ami3go/StepLoad-Arduino-UNO/Pictures/DSC_2040.JPG

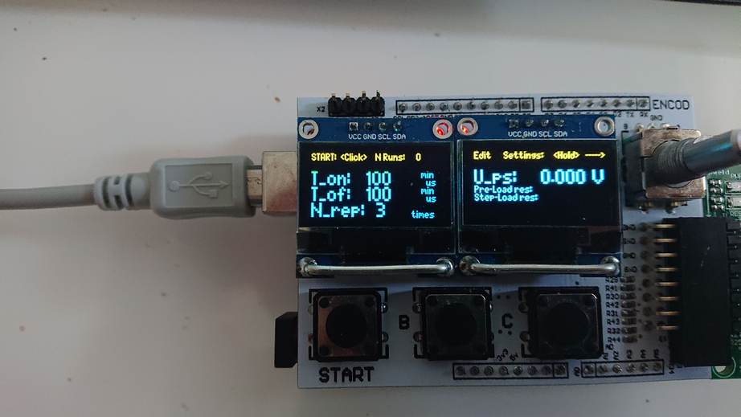
Pictures/DSC_2040.JPG
