ami3go/StepLoad-Arduino-UNO/Pictures/DSC_2055.JPG

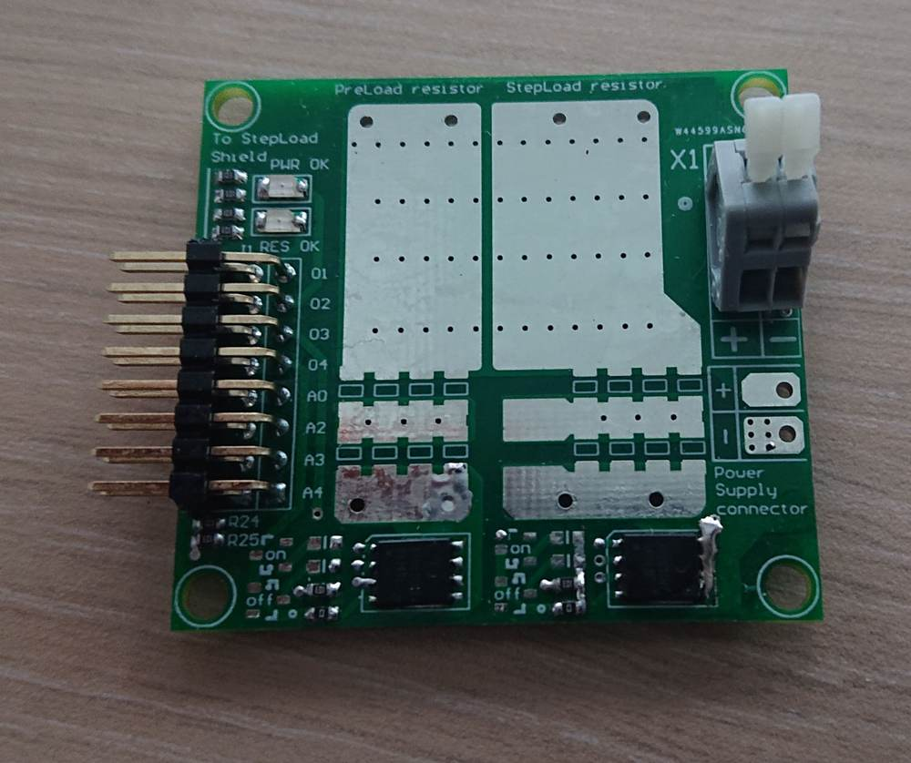
Pictures/DSC_2055.JPG
