ami3go/StepLoad-Arduino-UNO/Pictures/DSC_2058.JPG

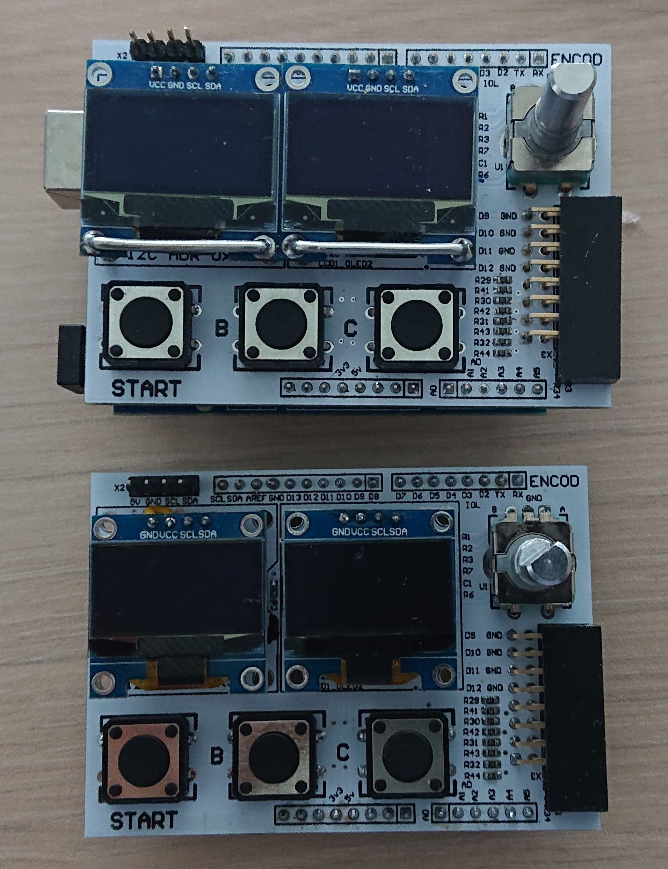
Pictures/DSC_2058.JPG
