ami3go/StepLoad-Arduino-UNO/Hardware/Shield_board/BOM/Bill of Materials-Arduino_Generator.xls

Designator | Description | Footprint | Quantity | Order Code
AD | 6 pins 2.54 header male | Header 6x1 8.5mm | 1
C1, C4_A, C4_B, C4_C, C5, C6, C7, C8 | 100nF 25V 0603 | 0603c | 8 | CC0603KRX7R8BB104
C2, C3 | 10nF 25V 5% 0603 NPO | 0603c | 2 | GRM1885C1E103JA01J
IOH | 10 pins 2.54 header male | Header 10x1 8.5mm | 1
IOL | 8 pins 2.54 header male | Header 8x1 8.5mm | 1
LCD1_OLED1, LCD1_OLED2 | SSD1306 OLED | 128x64I2COLEDDisplayAdafruit | 2 | link to Aliexpress (https://www.aliexpress.com/item/32277460222.html)
POWER | 8 pins 2.54 header male | Header 8x1 8.5mm | 1
R1, R2, R3, R10_A, R10_B, R10_C, R23, R24 | 10k 0603 5% | 0603r | 8 | RC0603JR-0710KL
R4, R5, R6, R7, R8, R9, R11_A, R11_B, R11_C, R12_A, R12_B, R12_C, R16, R20, R21, R22, R25, R26, R27, R28 | 100R 0603 1% | 0603r | 20 | RC0603FR-07100RL
R29, R30, R31, R32 | 10k 0603 1% | 0603r | 4 | RC0603FR-0710K
R33, R34, R37, R38 | 0R 0603 5% | 0603r | 4 | RC0603JR-070R
R41, R42, R43, R44 | 3.3KOhms 1% 1/10W 0603 RoHS | 0603r | 4 | RC0603FR-073K3L
SW1_A, SW1_B, SW1_C | Tactile switch 12x12mm Std Ht 7.3 Gen Purpose 130g | SWICH5B | 3 | 95C12C3T
U1 | Undefined or Miscellaneous | ACZ11BR1E15FD112C | 1 | ACZ11BR1E-15FD1-12C
U2 | 256 Kb I2C 2 Wire (32K X 8) 2.5 V Serial EEPROM SMT - SOIC-8 | SO8_P1.27_W3.9_L4.90 | 1 | 24LC256-I/SN
U3, U4 | 3A Dual High-Speed Power MOSFET Drivers, Non Inverting, Extended Temperature, Tape and Reel | SOIC-OA8_L | 2 | TC4424AVOA713, [NoParam]
VD1, VD2 | 40V 250mA 0.57V 5ns 6pF | SOT-23-3 | 2 | BAT64E6327
X2 | 4pin 2.54 vertical | M20-9990445 | 1 | M20-9990445
X3 | SQ Post Socket, Through-hole, Right Angle, -55 to 125 degC, 2.54mm Pitch, 16-Pin, Female, RoHS | SMTC-SSW-108-02-X-D-RA | 1 | SMTC-SSW-108-02-X-D-RA
