ami3go/StepLoad-Arduino-UNO/Hardware/Switch_board_small/SwitchBoard_small.PDF

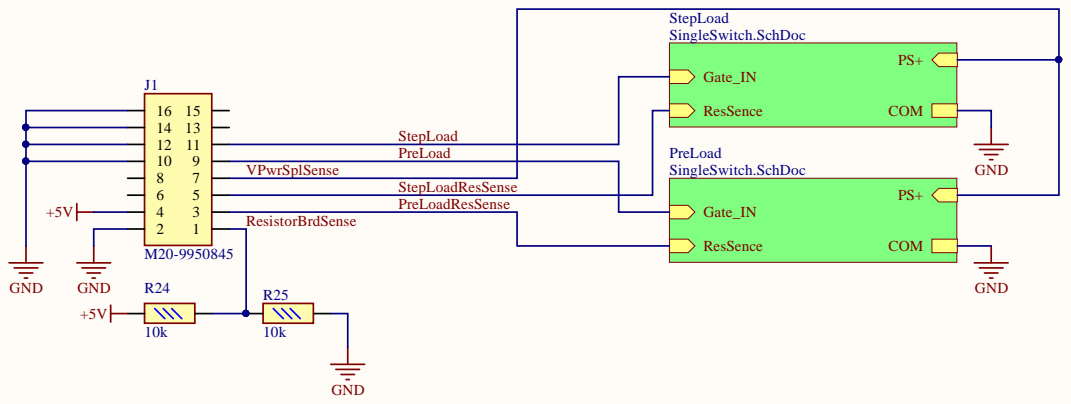
[picture p36: page 1]

StepLoad
PreLoad

VPwrSplSense

StepLoadResSense | PS+ Gate_IN
PreLoadResSense

ResistorBrdSense

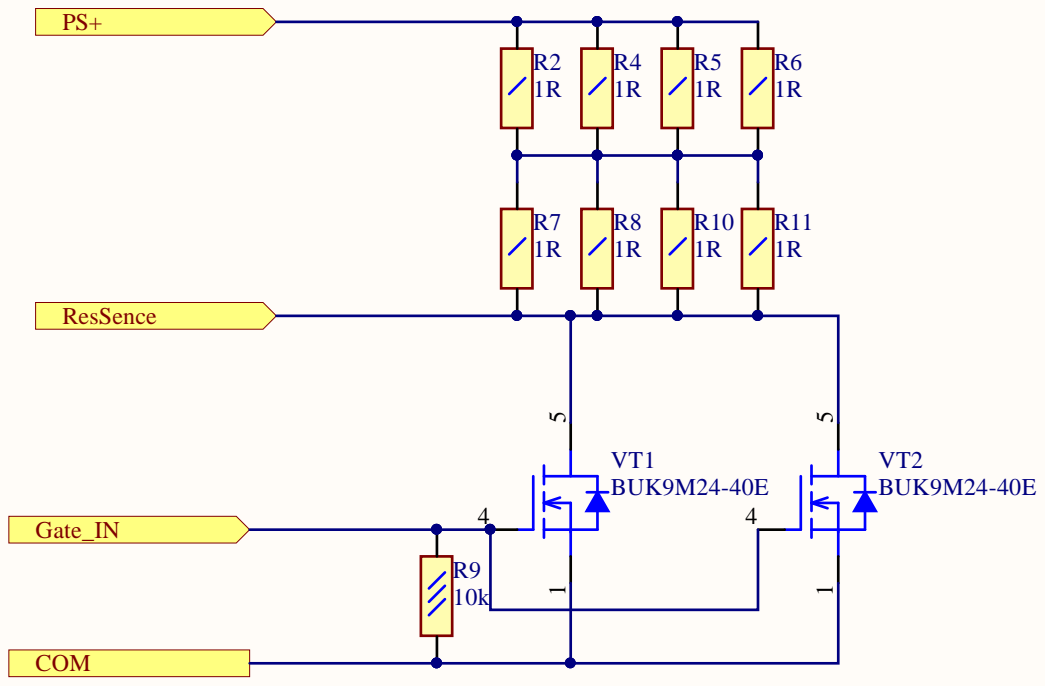
[picture p37: page 2]

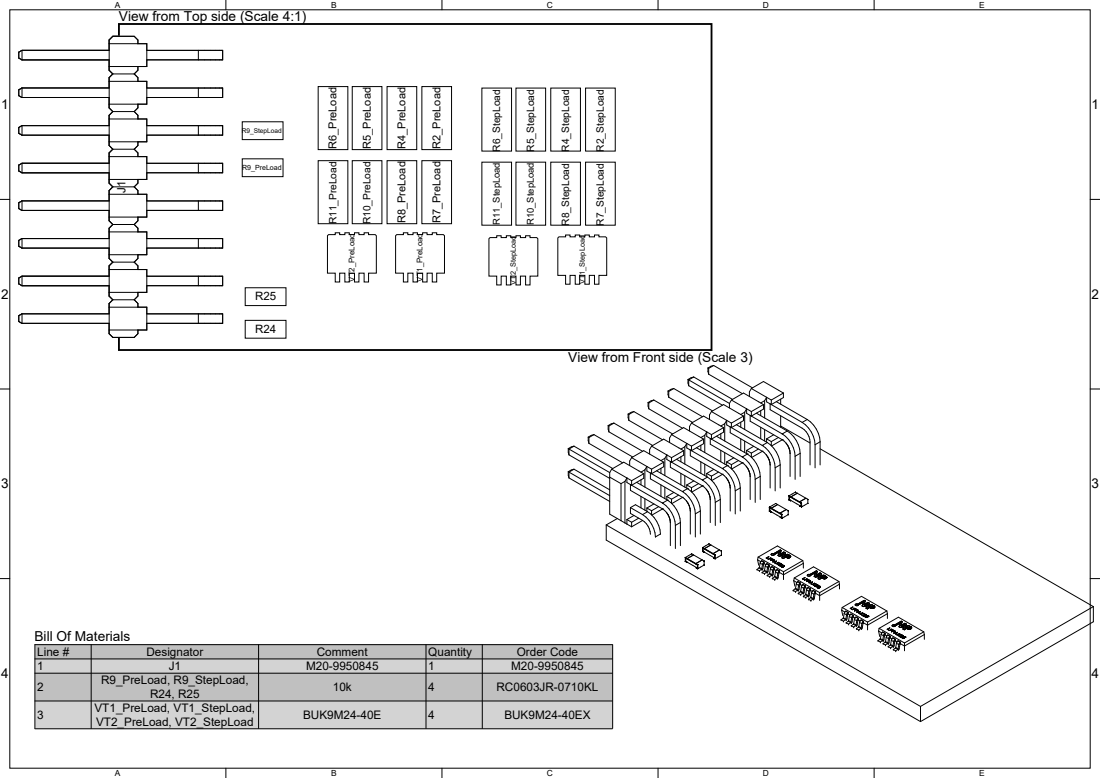
[picture p38: page 3]

View from Top side (Scale 4:1)

View from Front side (Scale 3)
