ami3go/StepLoad-Arduino-UNO/Hardware/Shield_board/Schematic/Arduino_Generator.PDF

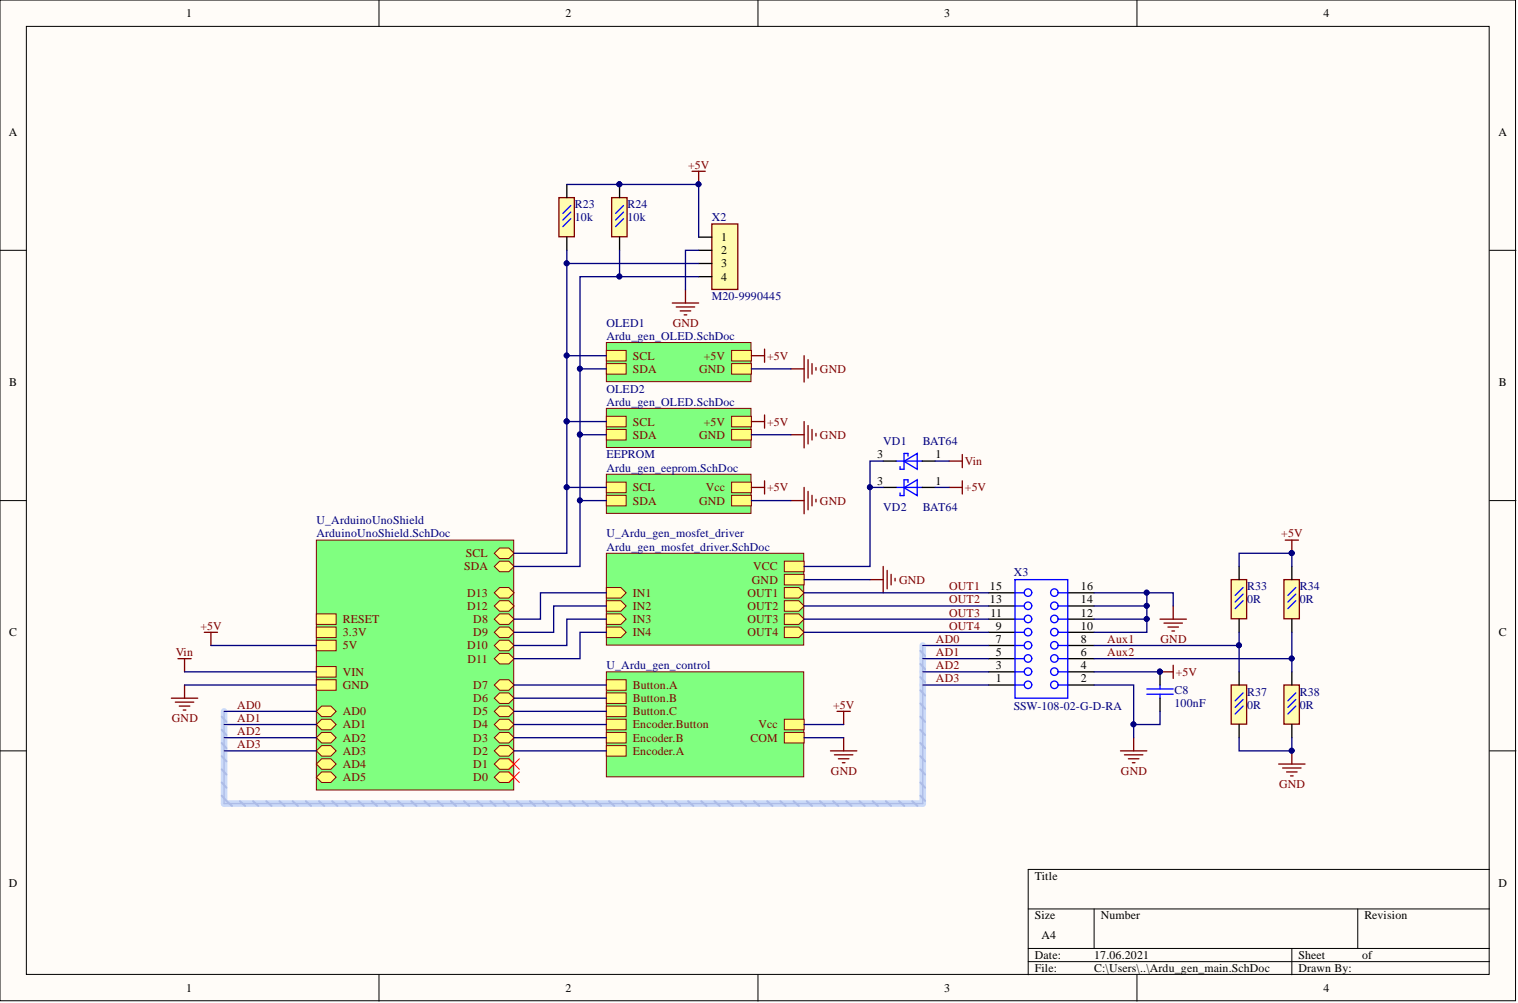
[picture p39: page 1]

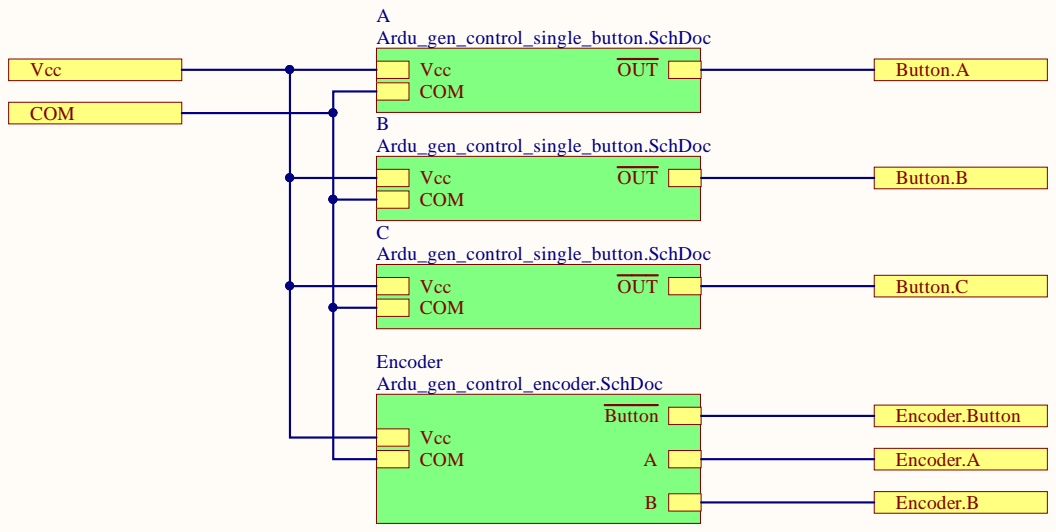
[picture p40: page 2]

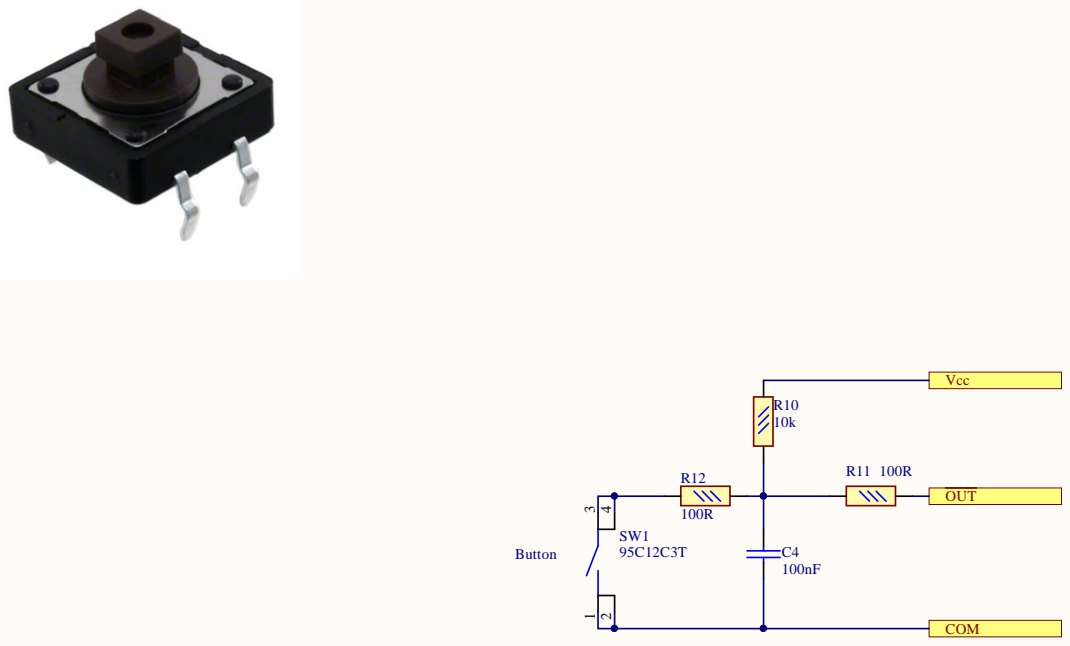
[picture p41: page 3]

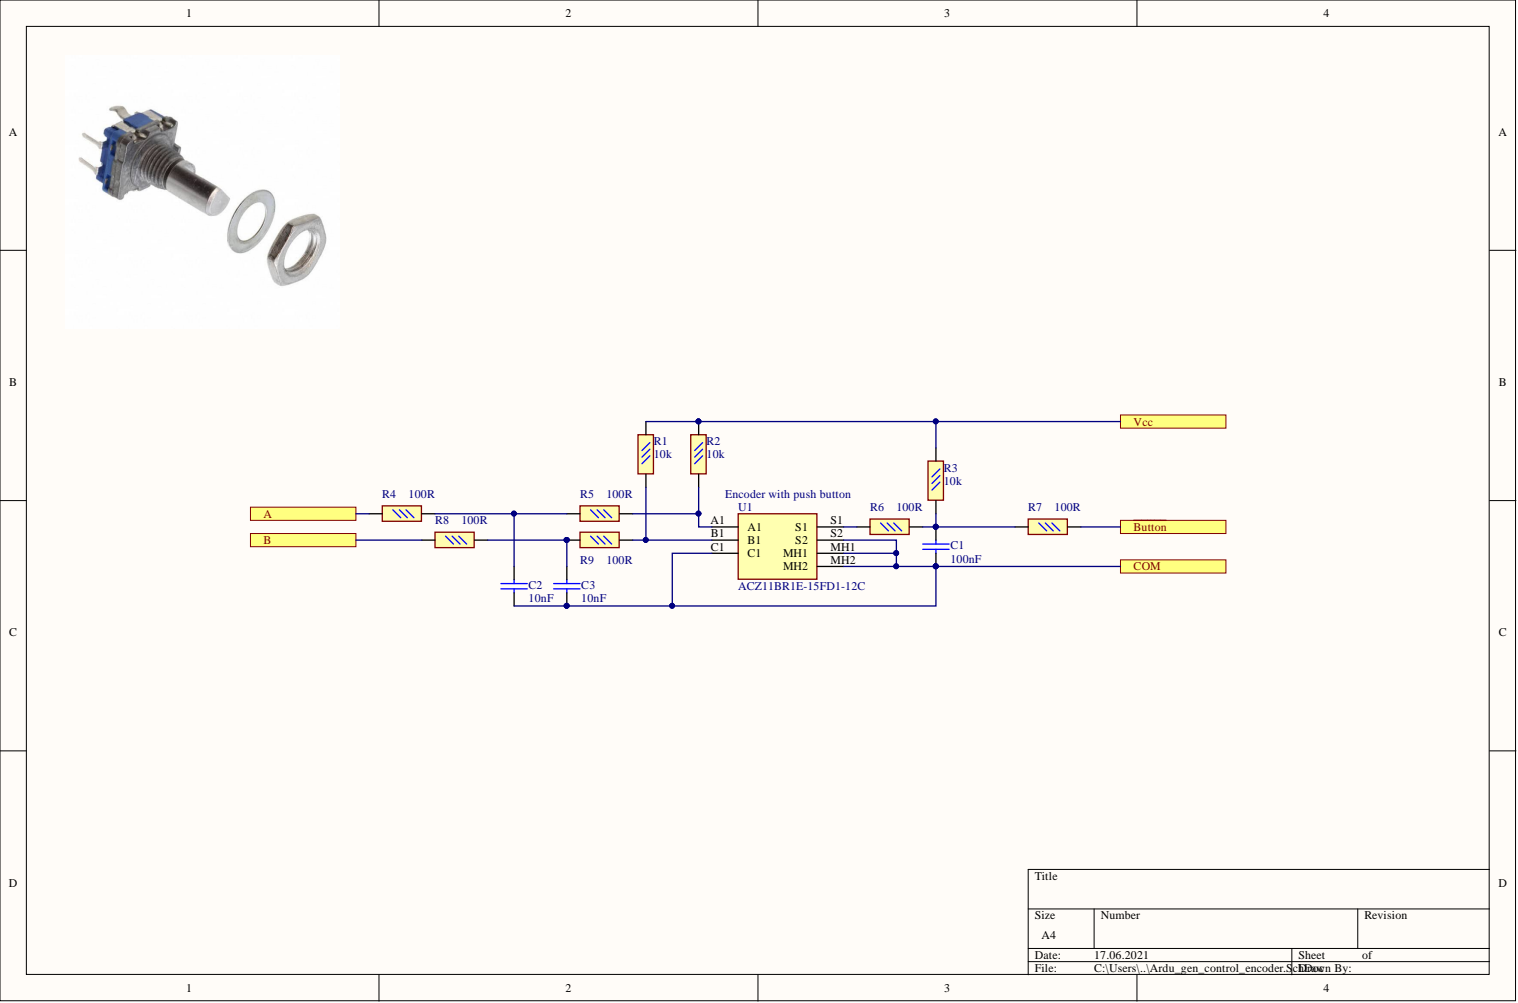
[picture p42: page 4]

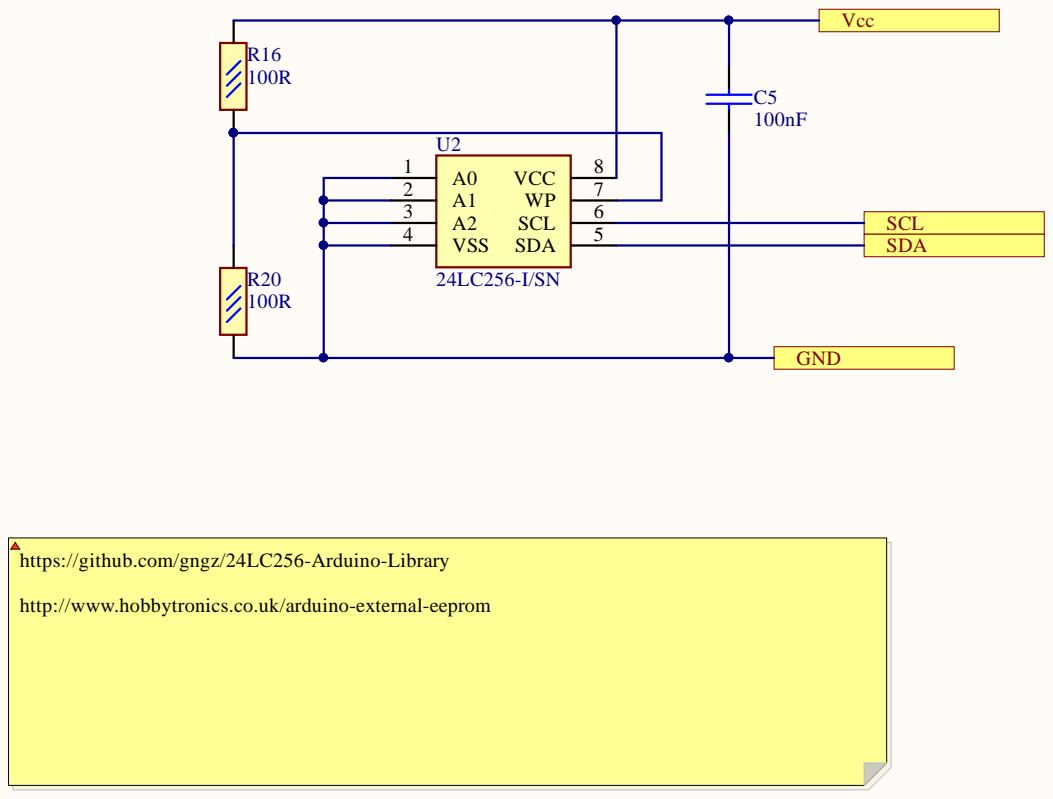
[picture p43: page 5]

https://github.com/gngz/24LC256-Arduino-Library

http://www.hobbytronics.co.uk/arduino-external-eeprom

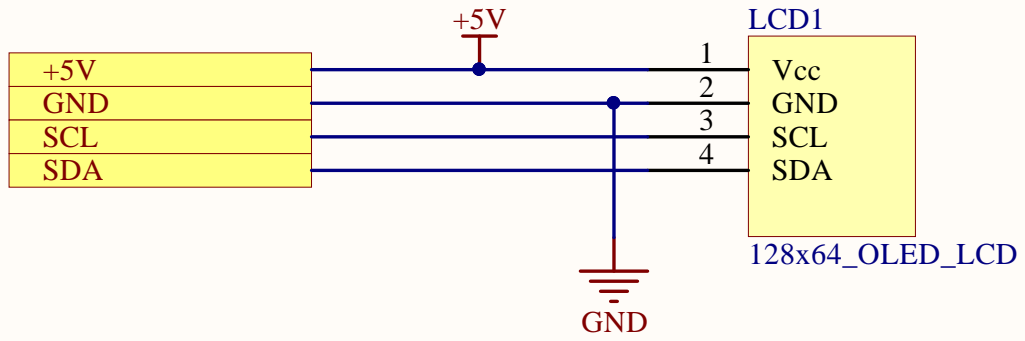
[picture p44: page 6]

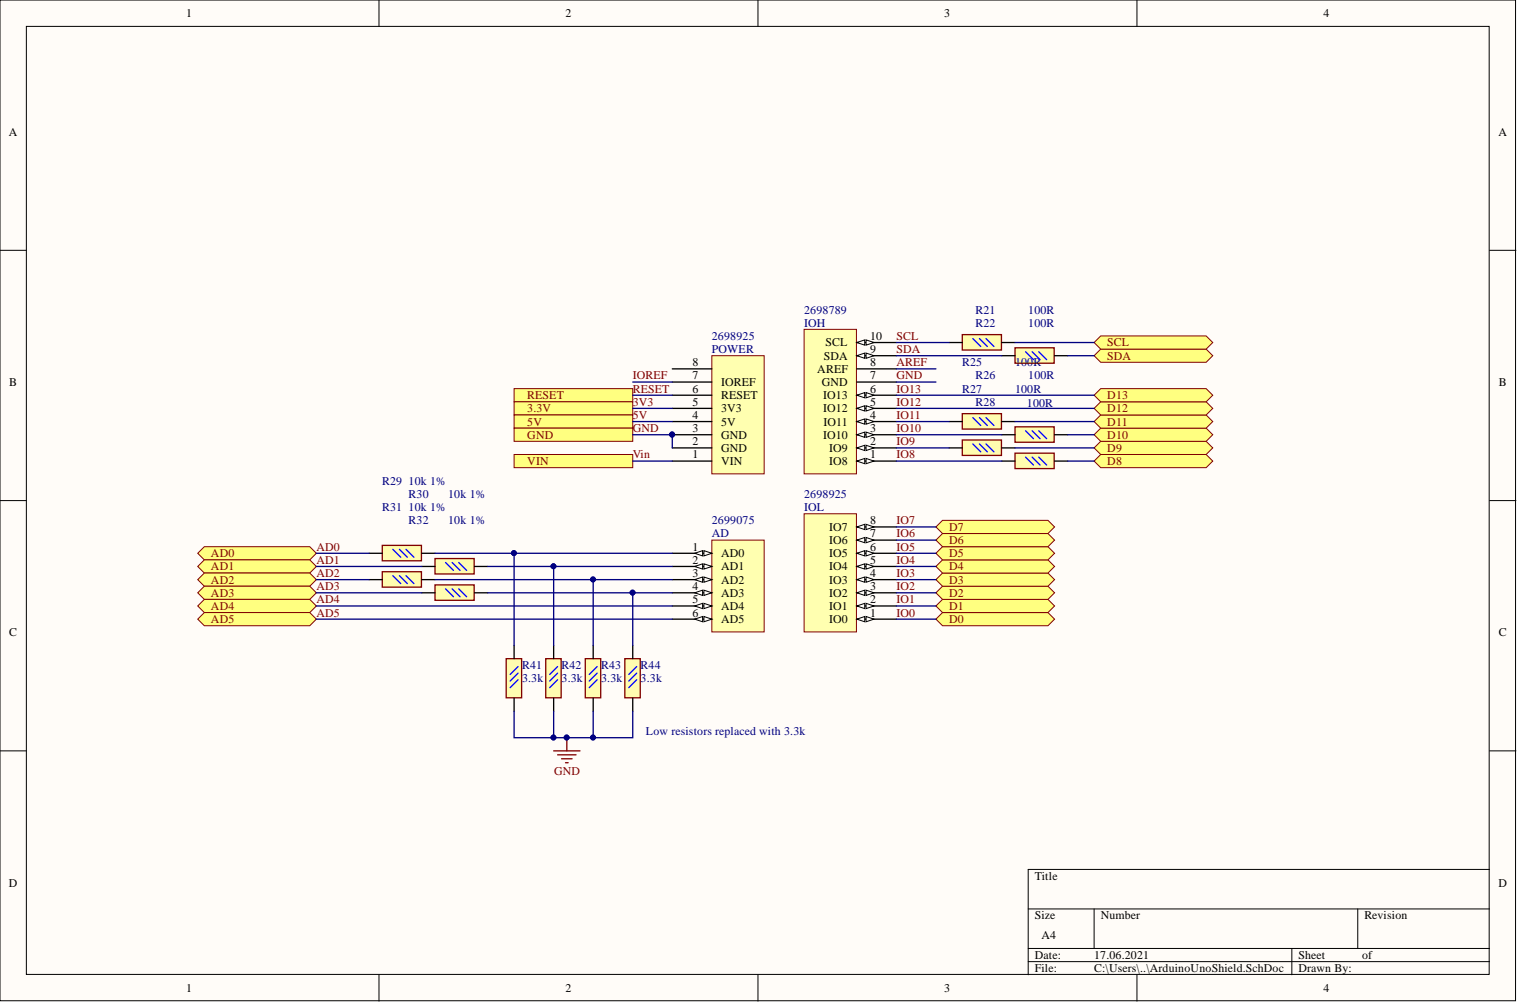
[picture p45: page 7]

Low resistors replaced with 3.3k

View from Top side (Scale 3)

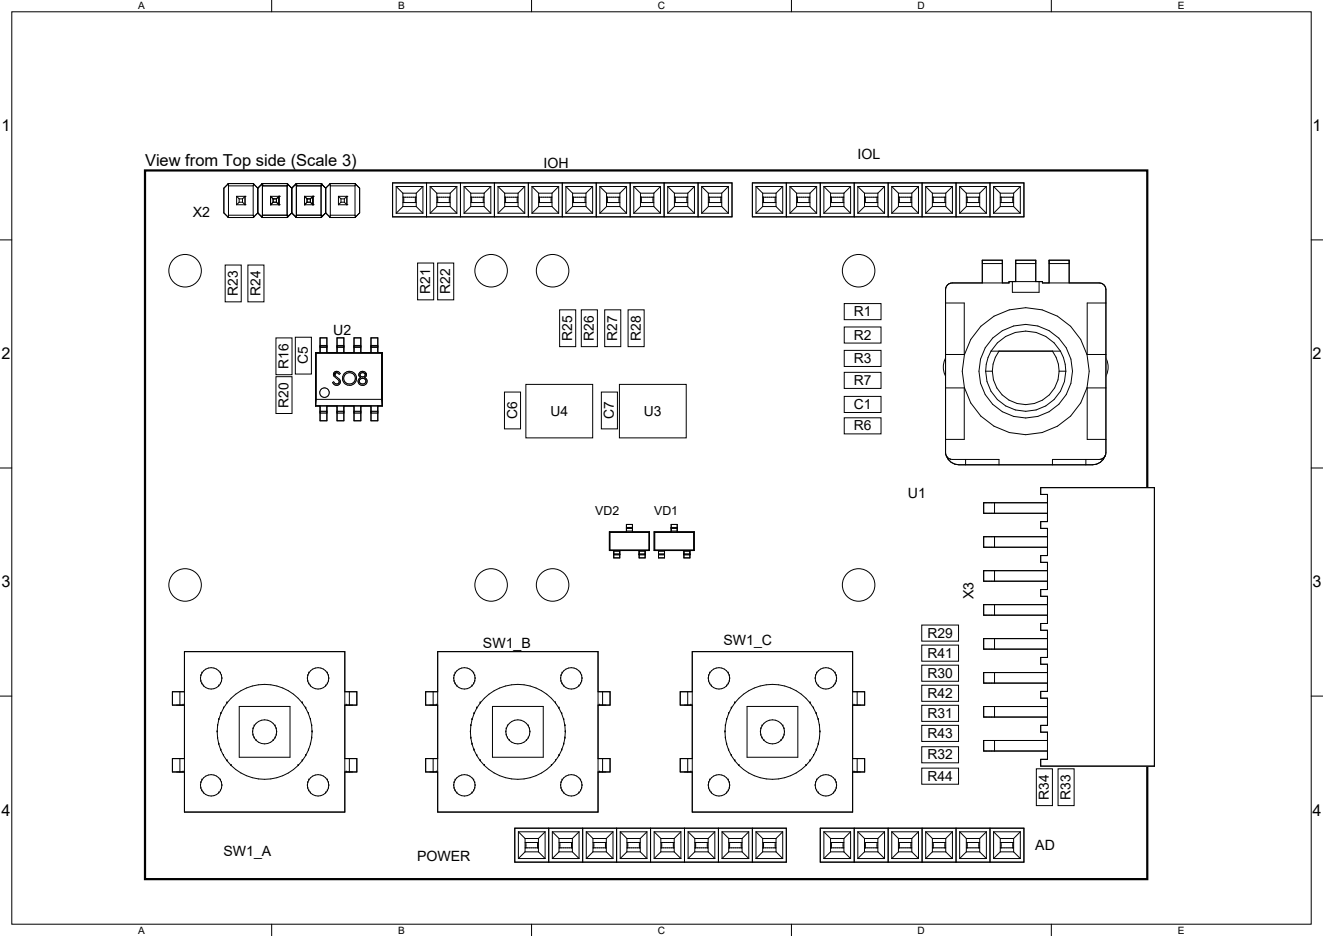
[picture p46: page 9]

View from Top side (Scale 3)

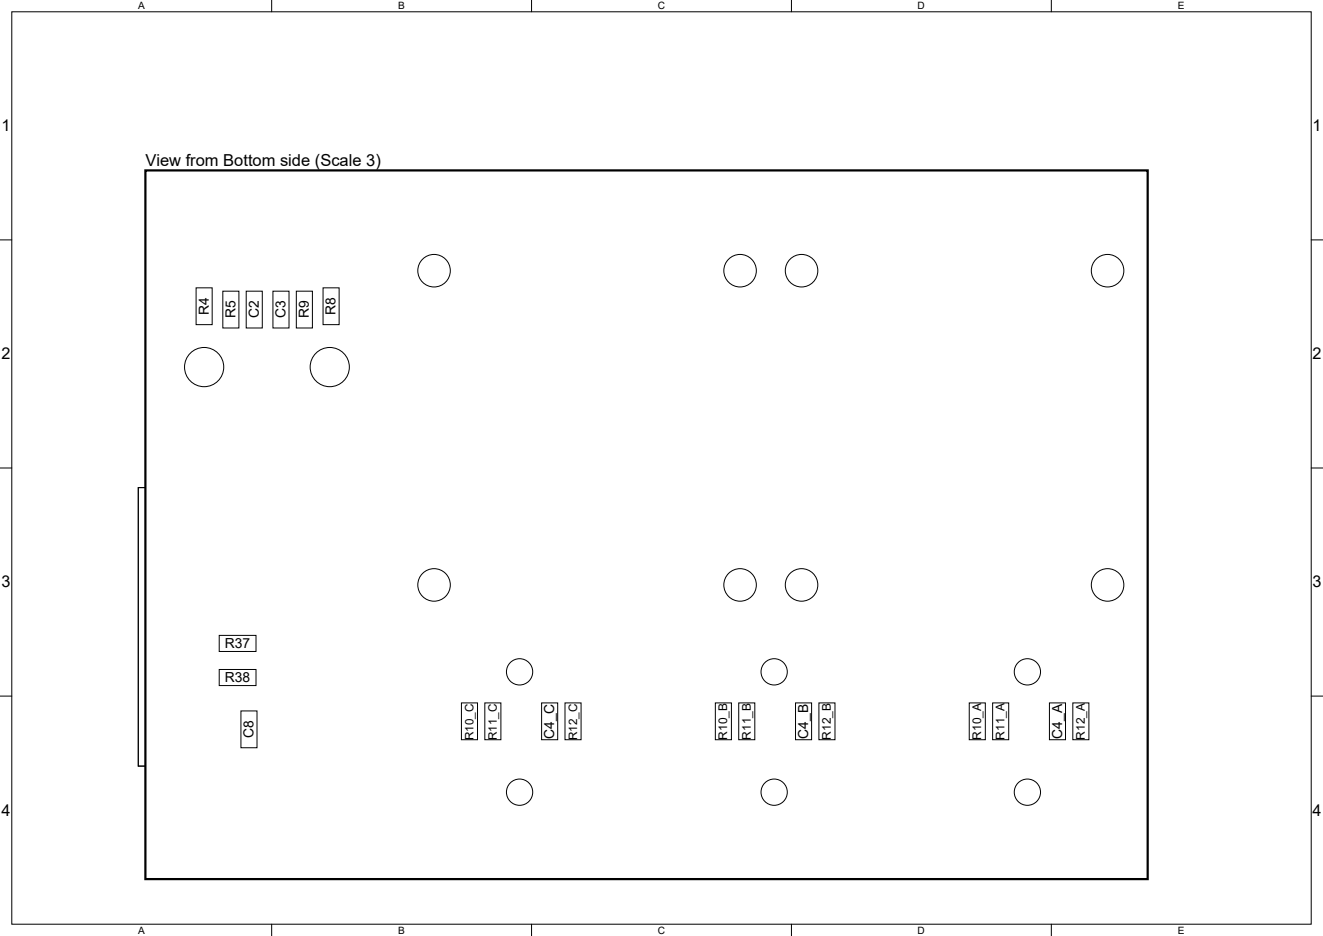
[picture p47: page 10]

View from Bottom side (Scale 3)

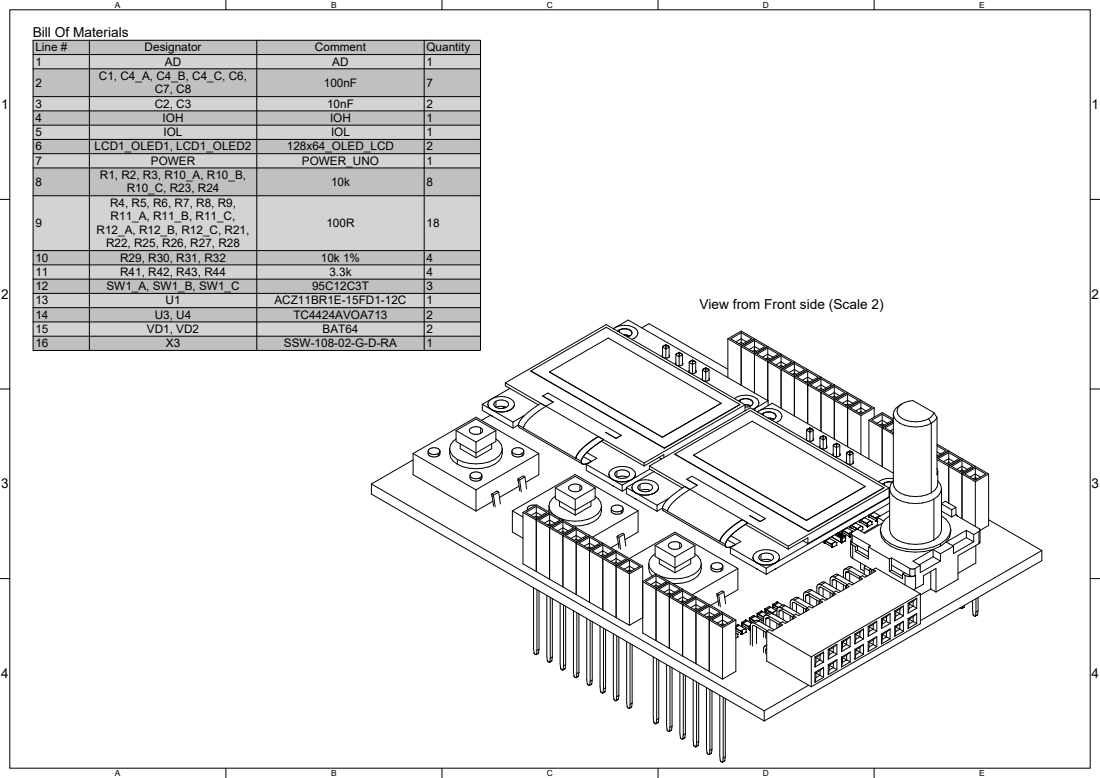
[picture p48: page 11]

Line # | Designator | Comment | Quantity

3 | C2, C3 | 10nF | 2
4 | IOH | IOH | 1
5 | IOL | IOL | 1
6 | LCD1_OLED1, LCD1_OLED2 | 128x64_OLED_LCD | 2
7 | POWER | POWER_UNO | 1
8 | R1, R2, R3, R10_A, R10_B, R10_C, R23, R24 | 10k | 8

10 | R29, R30, R31, R32 | 10k 1% | 4
11 | R41, R42, R43, R44 | 3.3k | 4
12 | SW1_A, SW1_B, SW1_C | 95C12C3T | 3
13 | U1 | ACZ11BR1E-15FD1-12C | 1
14 | U3, U4 | TC4424AVOA713 | 2
15 | VD1, VD2 | BAT64 | 2
16 | X3 | SSW-108-02-G-D-RA | 1

View from Front side (Scale 2)

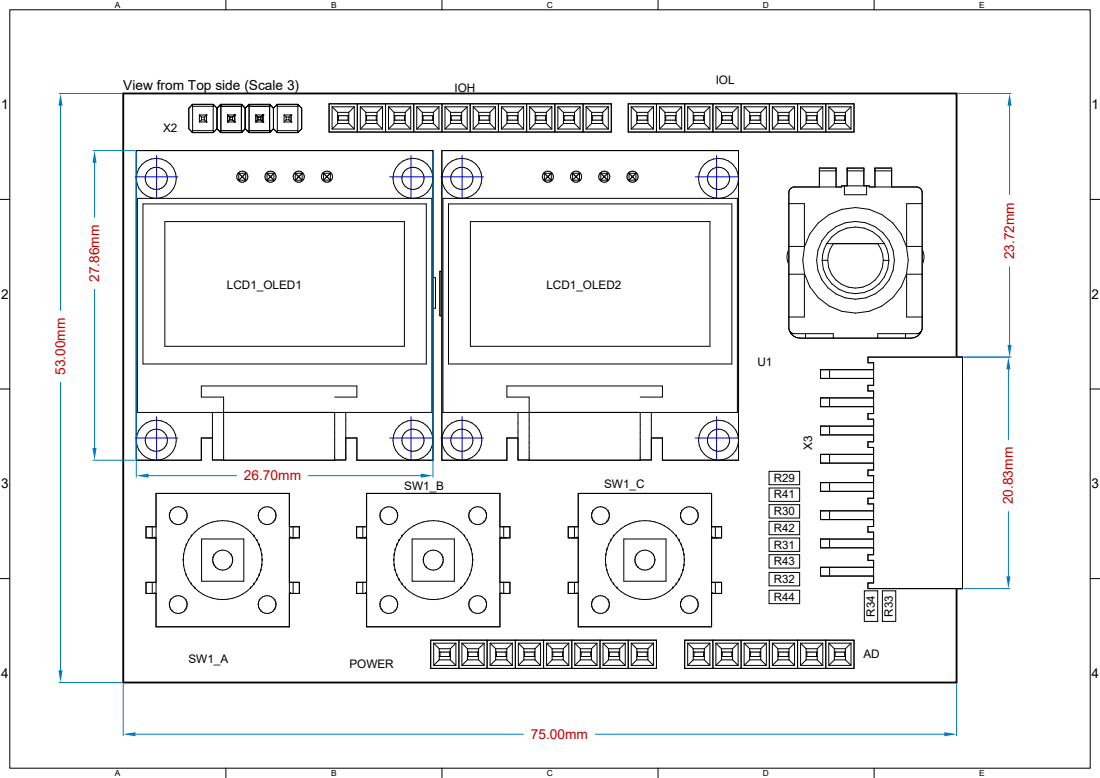
[picture p49: page 12]

View from Top side (Scale 3)

View from Top side (Scale 3)

View from Bottom side (Scale 3)

Line # | Designator | Comment | Quantity

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

View from Front side (Scale 2)
