ami3go/StepLoad-Arduino-UNO/Hardware/Switch_board/Schematic/ResistorBox.pdf

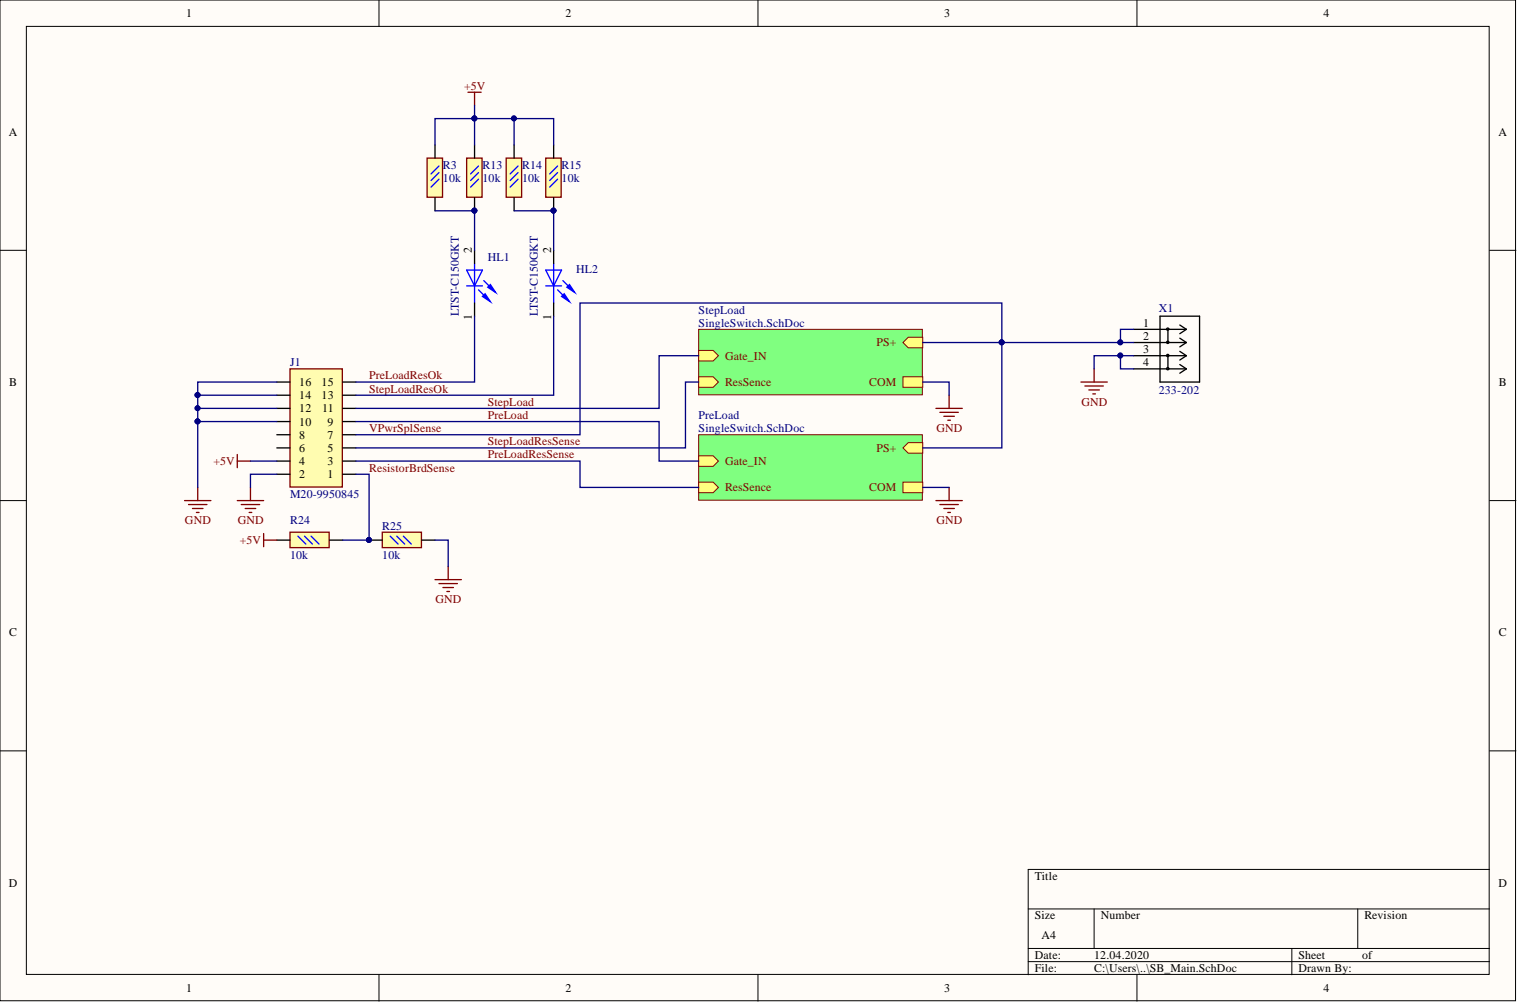
[picture p50: page 1]

PreL oadRes O k
Step L oadRes O k

PreL oad

VPwrSp lSen s e

Step L oadResSen s e | PS+ Gate_IN
PreL oadResSen s e

Res i s t orBrdSen s e

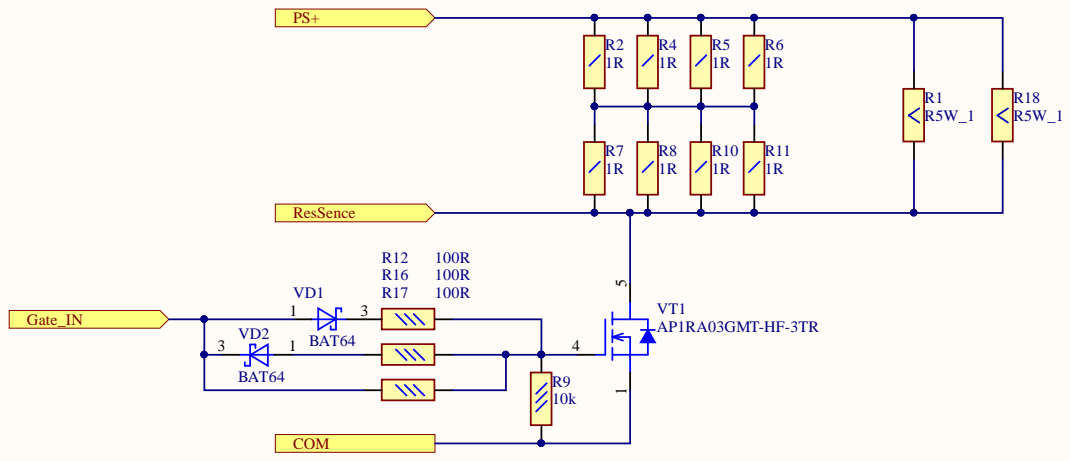
[picture p51: page 2]

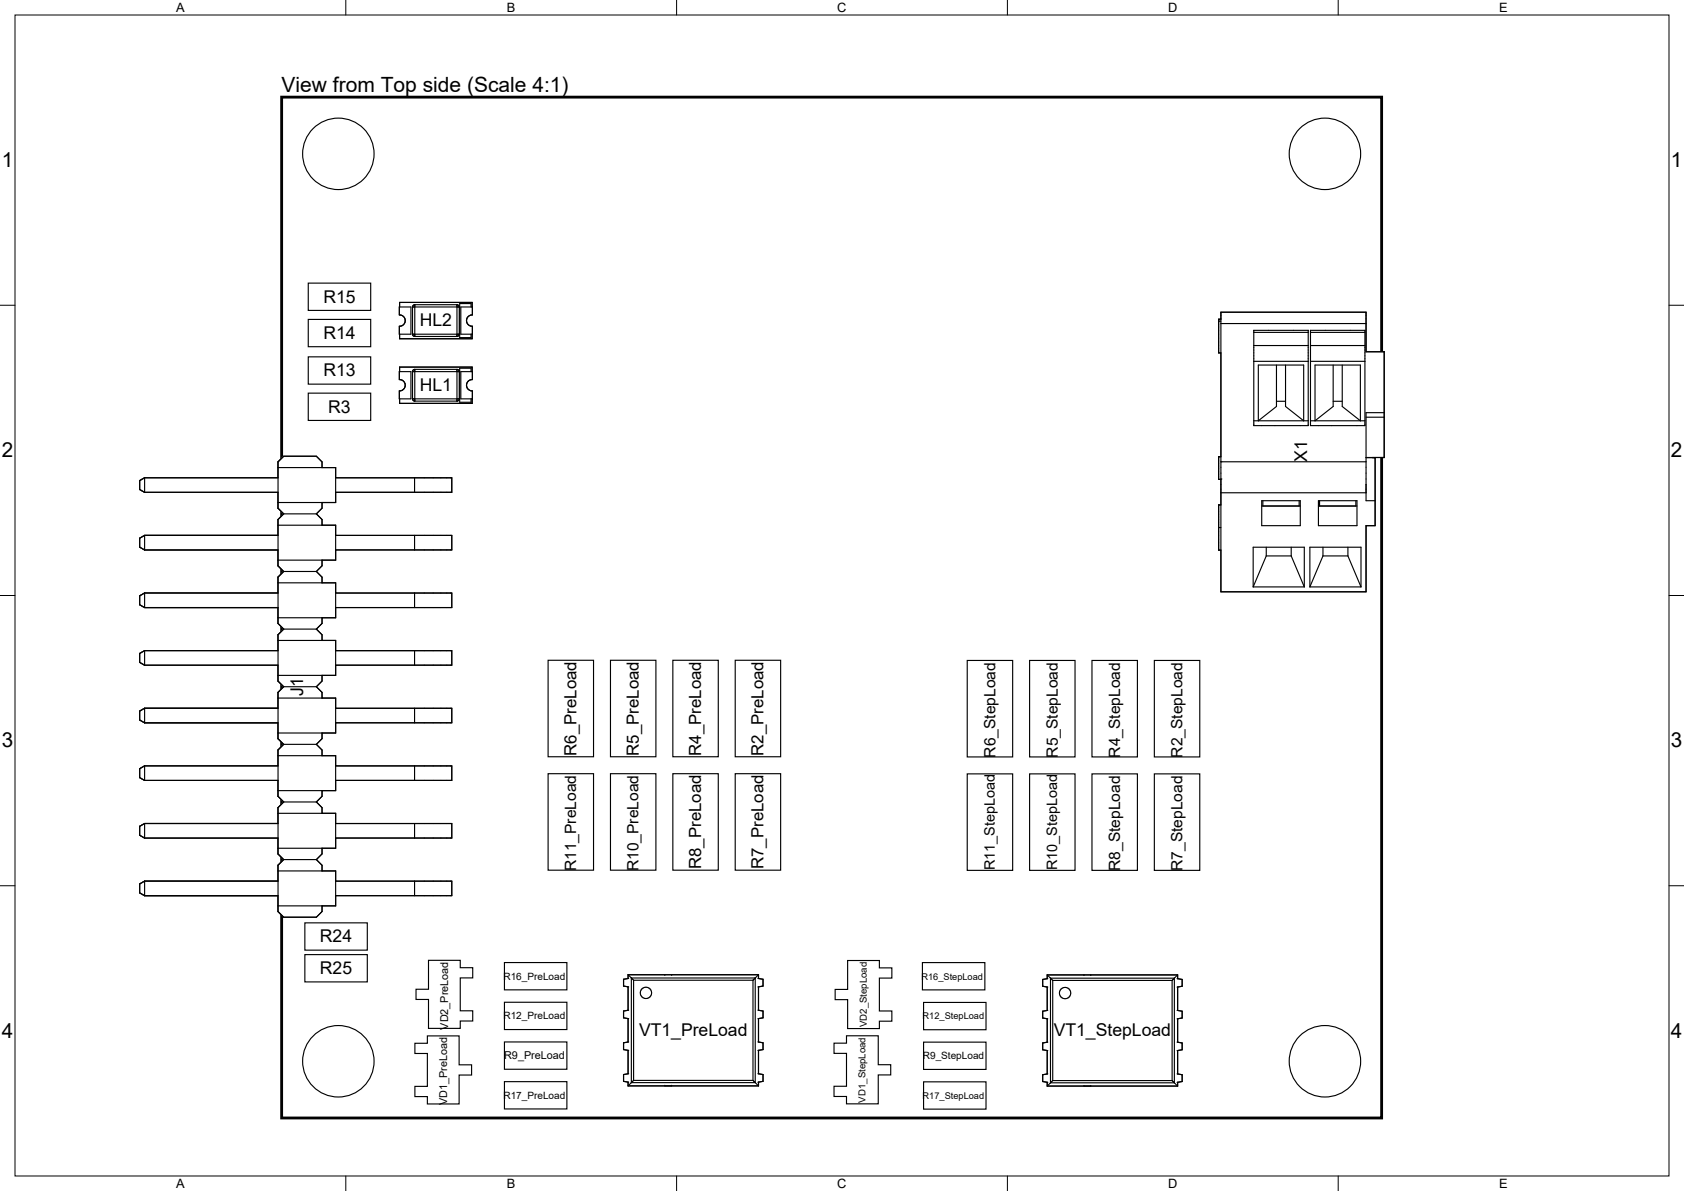
[picture p52: page 3]

View from Top side (Scale 4:1)

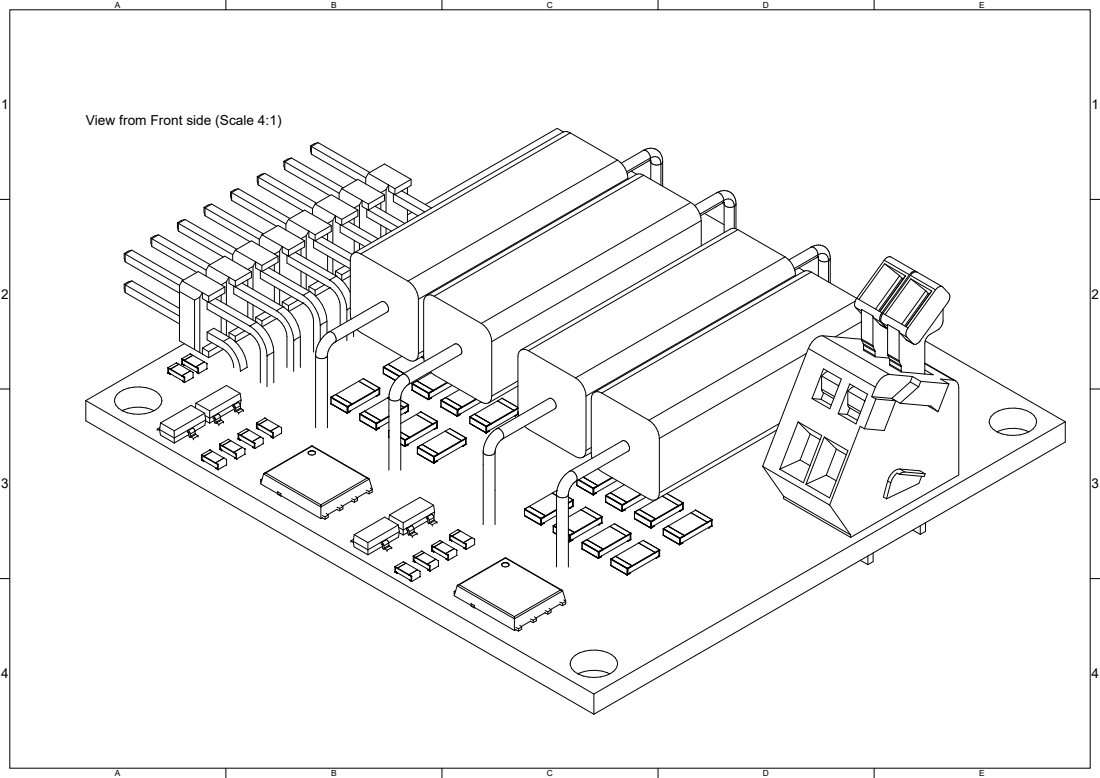
[picture p53: page 4]

View from Front side (Scale 4:1)
