ami3go/StepLoad-Arduino-UNO/(commit log)

2021-04-29 rename *ino file as folder name
    rename *ino file as folder name. Arduino IDE requirements
2021-05-27 added gerbers
    added gerbers
2021-06-18 Added small resistor board
    [Bill of Materials-Arduino_Generator.xls]
2021-06-18 Update Bill of Materials-Arduino_Generator.xls
    [Bill of Materials-Arduino_Generator.xls]
